Gamecooler19/MoneyLaundring/simulation/pinion.stl

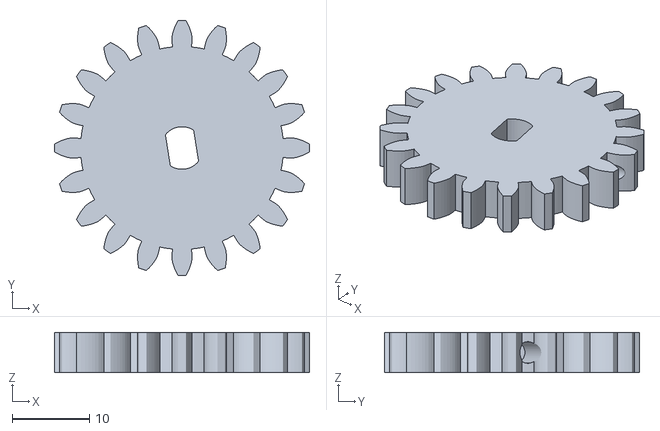
[picture p1: CAD file, 2026-11-01]
simulation/pinion.stl
33.0 x 33.0 x 5.20
