Gamecooler19/MoneyLaundring/simulation/tool_holder.stl

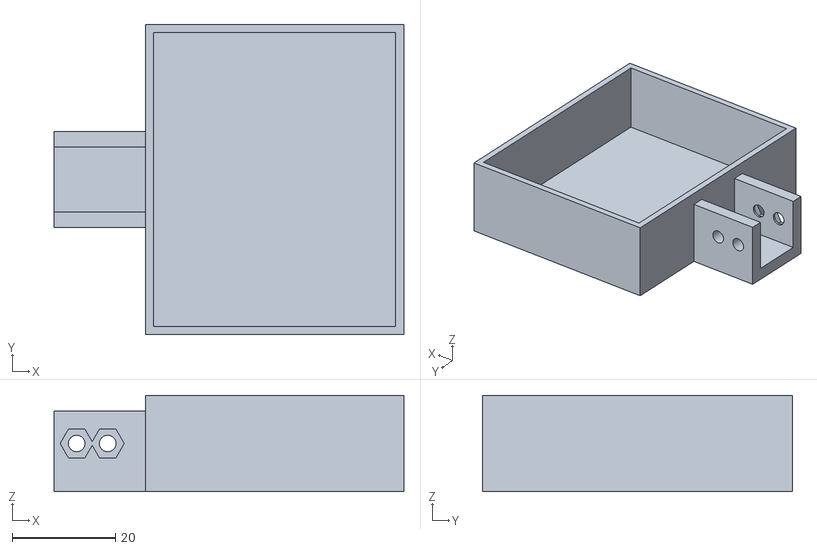
[picture p2: CAD file, 2026-11-01]
simulation/tool_holder.stl
67.7 x 60.0 x 18.6
