Gamecooler19/MoneyLaundring/simulation/rack.stl

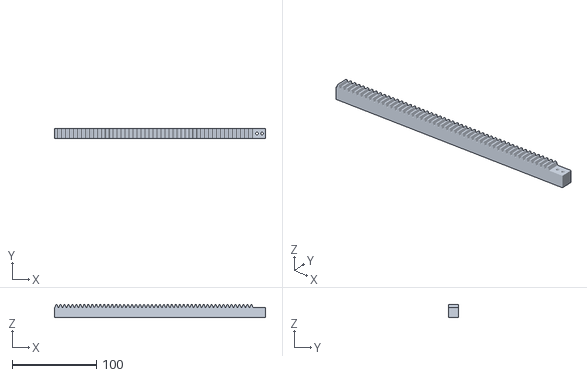
[picture p3: CAD file, 2026-11-01]
simulation/rack.stl
250.0 x 12.0 x 15.4
