Gamecooler19/MoneyLaundring/simulation/junction.stl

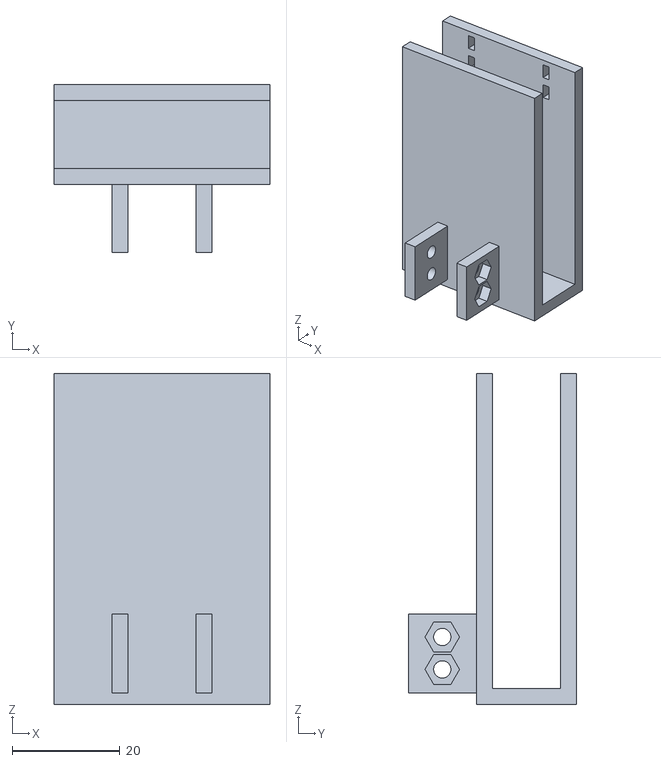
[picture p4: CAD file, 2026-11-01]
simulation/junction.stl
40.0 x 31.2 x 61.3
