Gamecooler19/MoneyLaundring/simulation/guide.stl

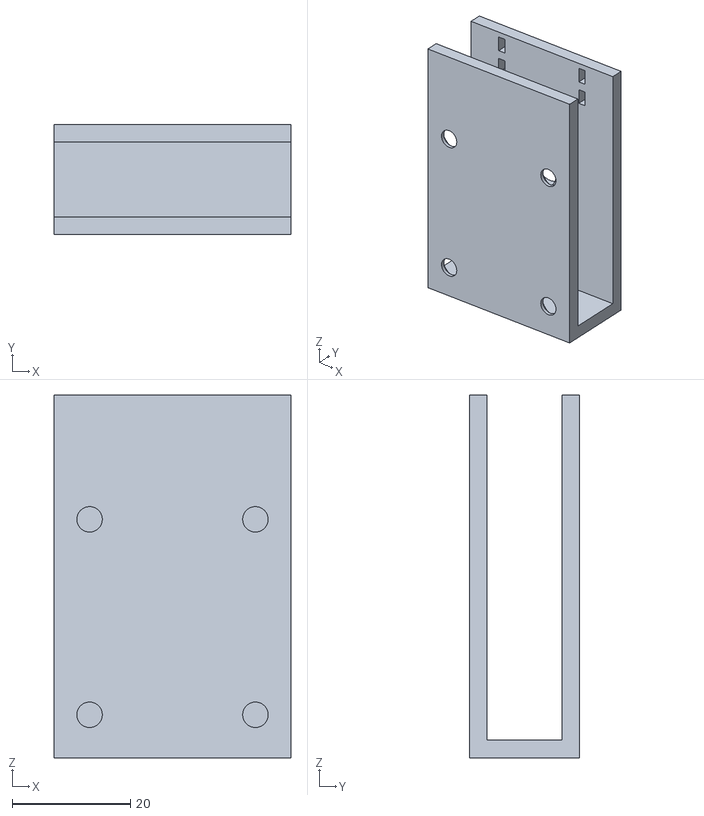
[picture p5: CAD file, 2026-11-01]
simulation/guide.stl
40.0 x 18.6 x 61.3
