Gamecooler19/MoneyLaundring/(commit log)

2026-11-01 fix: module 4 - discard overlong console lines through the newline
    [BringupConsole.cpp, BringupConsole.h]
2026-11-01 feat: module 4 - gate jogs against an engaged ahead sensor, with force override
2026-11-01 fix: module 4 - correct auto-run boot message to say hardware reset, not power-on
    [BringupConsole.cpp]
2026-11-01 Add CAD-derived gantry simulator
    Bundle the CAD and STL assets with a browser simulator whose travel limits are derived from SCAD tooth pitch and endpoint positions.
    [alt1_print.scad, guide.stl, junction.stl, pinion.stl, rack.stl, tool_holder.stl]
